SB-Chalmers/mrstudio-printing/media/base_grid.png

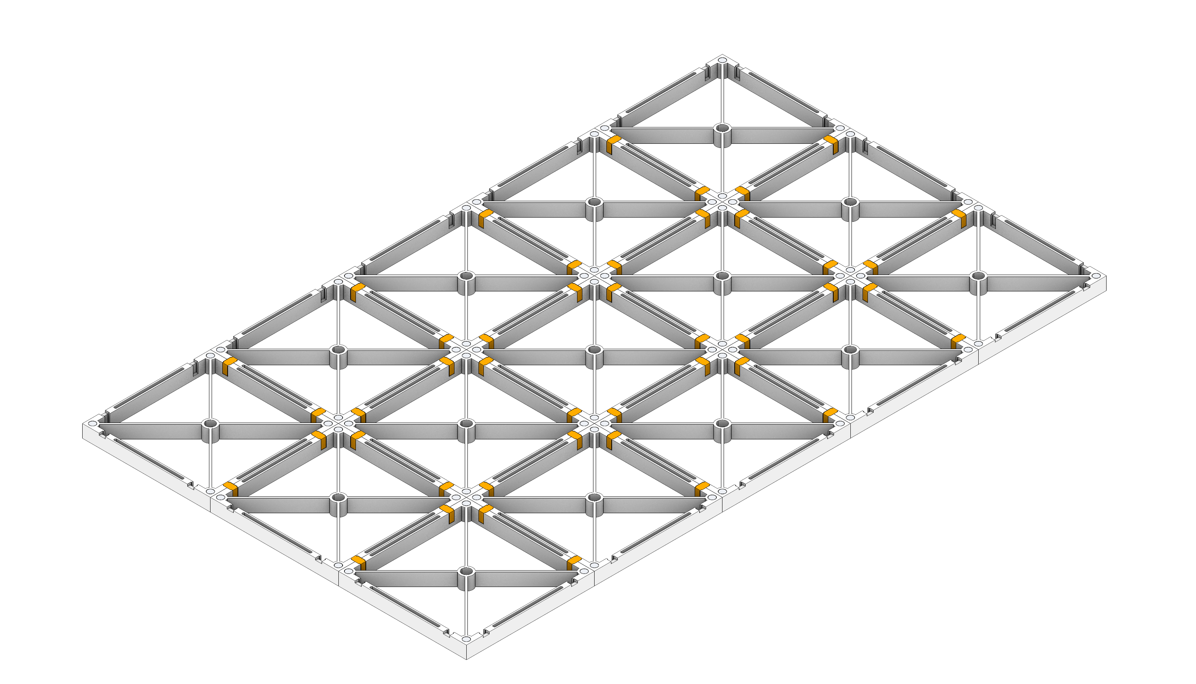
media/base_grid.png
