SB-Chalmers/mrstudio-printing/base_tiles/connectors_x24.stl

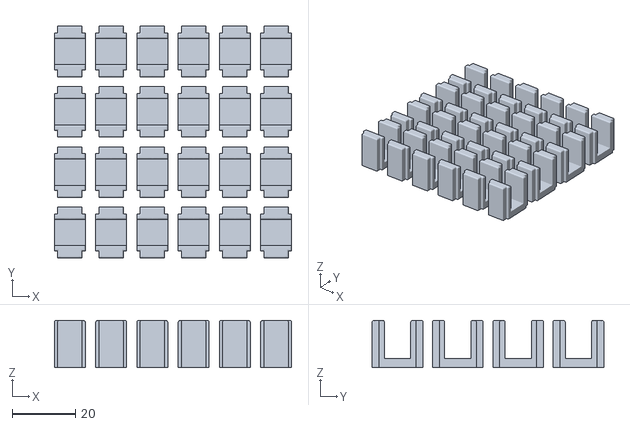
[picture p12: CAD file, 2026-11-02]
base_tiles/connectors_x24.stl
74.7 x 73.0 x 14.9
