SB-Chalmers/mrstudio-printing/base_tiles/end_caps_x24.stl

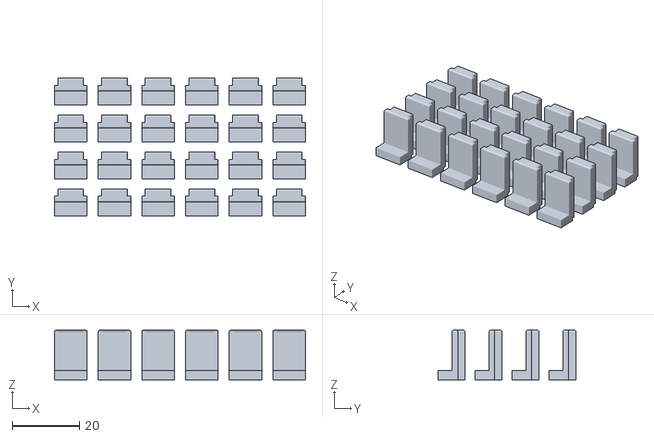
[picture p13: CAD file, 2026-11-02]
base_tiles/end_caps_x24.stl
74.7 x 41.0 x 14.9
