SB-Chalmers/mrstudio-printing/base_tiles/base_200x200.stl

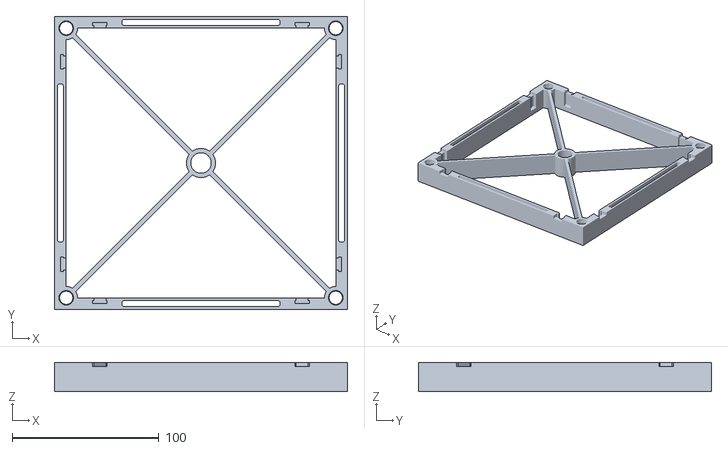
[picture p14: CAD file, 2026-11-02]
base_tiles/base_200x200.stl
200.0 x 200.0 x 20.0
